seetharamana03/dc-programmable-load/(commit log)

2026-05-27 initial project commit
    [dc_programmable_load.kicad_pcb, dc_programmable_load.kicad_sch]
2026-06-01 fixed op-amp pin names
    [dc_programmable_load.kicad_sch]
2026-06-03 testing for aidan
    [dc_programmable_load.kicad_sch]
2026-06-07 added components from dev doc
    [dc_programmable_load.csv, dc_programmable_load.kicad_sch]
2026-06-10 changed footprints
    [dc_programmable_load.kicad_pcb, dc_programmable_load.kicad_sch]
2026-06-14 version 1 of the PCB
    [dc_programmable_load.kicad_pcb, dc_programmable_load.kicad_sch]
2026-06-18 revised board and changed to buck
    [dc_programmable_load.kicad_pcb, dc_programmable_load.kicad_sch]
2026-06-19 Update KiCad PCB, schematic, and project layout files
    [dc_programmable_load.kicad_pcb, dc_programmable_load.kicad_sch]
2026-06-20 should be final version
    [dc_programmable_load.kicad_pcb]
2026-07-12 Add v2 and m1_key KiCad designs; ignore .history dumps
    [dc_programmable_load.kicad_pcb, dc_programmable_load.kicad_sch, dc_programmable_load_m1_key.csv, dc_programmable_load_m1_key.kicad_pcb, dc_programmable_load_m1_key.kicad_sch, dc_programmable_load_v2.csv, dc_programmable_load_v2.kicad_pcb, dc_programmable_load_v2.kicad_sch]
2026-07-15 newest updates
    [bom.csv, bom2.csv, bom_c.csv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]
2026-07-15 Update v2 PCB, schematic, and project files
    [dc_programmable_load_v2.kicad_pcb, dc_programmable_load_v2.kicad_sch]
2026-07-16 Update v2 design files and m1_key PCB
    [dc_programmable_load_m1_key.kicad_pcb, dc_programmable_load_v2.kicad_pcb, dc_programmable_load_v2.kicad_sch]
2026-07-16 anand newest edits
    [bom.csv, bom_updated.csv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]
2026-07-16 Update v2 PCB layout and project settings
    [dc_programmable_load_v2.kicad_pcb]
2026-09-01 Update v2 schematic and PCB layout
    [dc_programmable_load_v2.kicad_pcb, dc_programmable_load_v2.kicad_sch]
